THEtheChad/STM32H753-Dashboard/Dash Reference.jpg

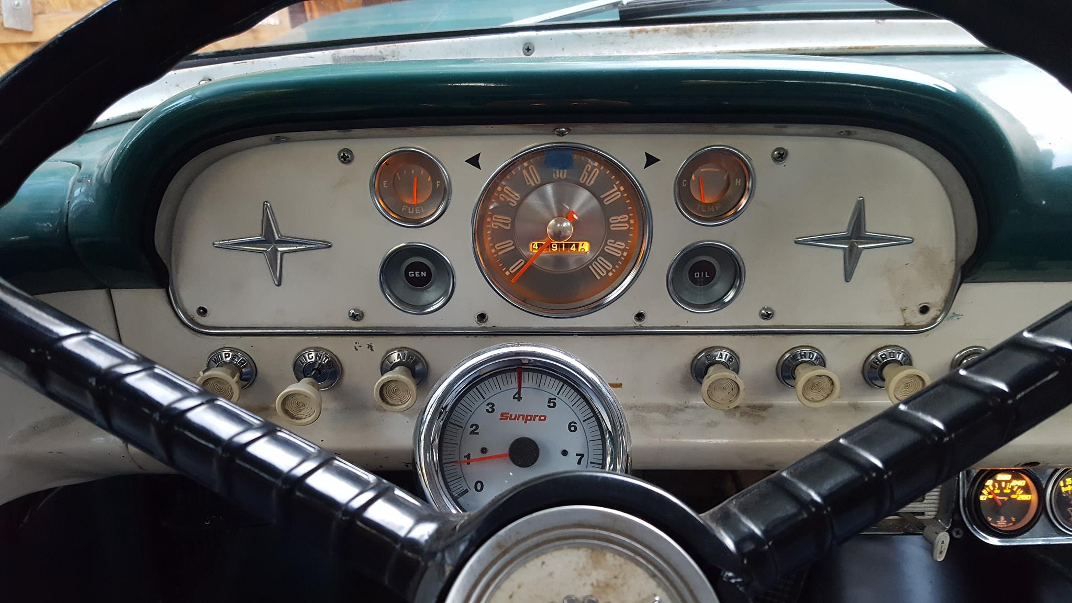
Dash Reference.jpg
