THEtheChad/STM32H753-Dashboard/docs/vss-jumper.png

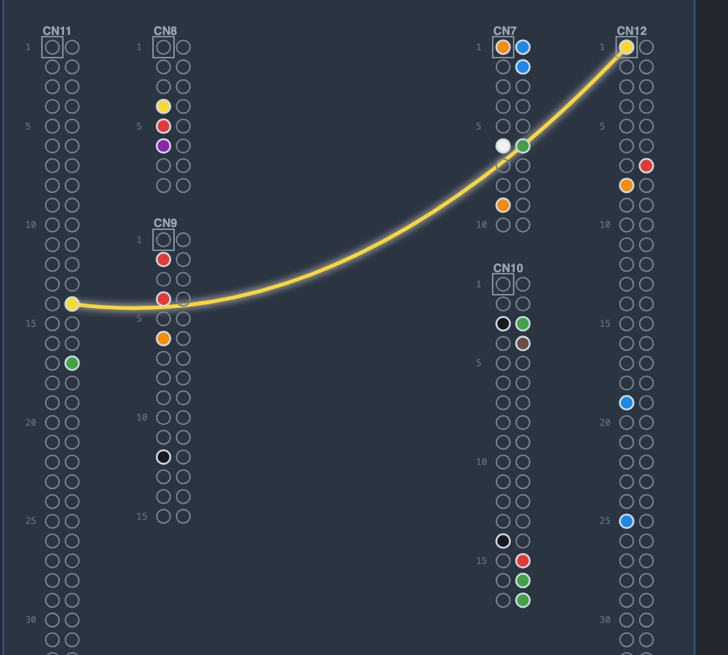
docs/vss-jumper.png
