THEtheChad/STM32H753-Dashboard/Core/Src/main.c

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
/* Includes ------------------------------------------------------------------*/
#include "main.h"

/* USER CODE BEGIN Includes */
#include "st77916.h"
#include "nv3052c.h"
#include "holley_can.h"
#include "sensors.h"
#include "inputs.h"
#include "config.h"
/* USER CODE END Includes */

ADC_HandleTypeDef hadc1;

DMA2D_HandleTypeDef hdma2d;

FDCAN_HandleTypeDef hfdcan1;

I2C_HandleTypeDef hi2c1;

LTDC_HandleTypeDef hltdc;

QSPI_HandleTypeDef hqspi;

SPI_HandleTypeDef hspi1;

TIM_HandleTypeDef htim1;
TIM_HandleTypeDef htim2;
TIM_HandleTypeDef htim6;

UART_HandleTypeDef huart1;
UART_HandleTypeDef huart2;

void SystemClock_Config(void);
static void MPU_Config(void);
static void MX_GPIO_Init(void);
static void MX_ADC1_Init(void);
static void MX_DMA2D_Init(void);
static void MX_FDCAN1_Init(void);
static void MX_I2C1_Init(void);
static void MX_LTDC_Init(void);
static void MX_QUADSPI_Init(void);
static void MX_SPI1_Init(void);
static void MX_TIM1_Init(void);
static void MX_TIM2_Init(void);
static void MX_TIM6_Init(void);
static void MX_USART1_UART_Init(void);
static void MX_USART2_UART_Init(void);
/**
  * @brief  The application entry point.
  * @retval int
  */
int main(void)
{

  /* MPU Configuration--------------------------------------------------------*/
  MPU_Config();

  /* MCU Configuration--------------------------------------------------------*/

  /* Reset of all peripherals, Initializes the Flash interface and the Systick. */
  HAL_Init();

  /* USER CODE BEGIN Init */
  /* Framebuffer RAM (AXI SRAM) as write-through: CPU writes reach RAM
   * immediately and in order, so LTDC scanout never sees stale or
   * half-flushed pixels and no per-frame cache maintenance is needed.
   * With write-back this raced the scanline and tore the moving needle.
   * Region 0 (background) is CubeMX-generated; this stacks region 1. */
  {
    MPU_Region_InitTypeDef r = {0};
    HAL_MPU_Disable();
    r.Enable           = MPU_REGION_ENABLE;
    r.Number           = MPU_REGION_NUMBER1;
    r.BaseAddress      = 0x24000000U;
    r.Size             = MPU_REGION_SIZE_512KB;
    r.TypeExtField     = MPU_TEX_LEVEL0;          /* TEX=0, C=1, B=0 = write-through */
    r.AccessPermission = MPU_REGION_FULL_ACCESS;
    r.DisableExec      = MPU_INSTRUCTION_ACCESS_DISABLE;
    r.IsShareable      = MPU_ACCESS_NOT_SHAREABLE;
    r.IsCacheable      = MPU_ACCESS_CACHEABLE;
    r.IsBufferable     = MPU_ACCESS_NOT_BUFFERABLE;
    HAL_MPU_ConfigRegion(&r);
    HAL_MPU_Enable(MPU_PRIVILEGED_DEFAULT);
  }
  /* CPU caches were never enabled; the Cortex-M7 is crippled without them and
   * cache-maintenance ops (used for LTDC framebuffer coherence) hard-fault if
   * executed while the D-cache is off. MPU_Config() has already run. */
  SCB_EnableICache();
  SCB_EnableDCache();
  /* USER CODE END Init */

  /* Configure the system clock */
  SystemClock_Config();

  /* Initialize all configured peripherals */
  MX_GPIO_Init();
  MX_ADC1_Init();
  MX_DMA2D_Init();
  MX_FDCAN1_Init();
  MX_I2C1_Init();
  MX_LTDC_Init();
  MX_QUADSPI_Init();
  MX_SPI1_Init();
  MX_TIM1_Init();
  MX_TIM2_Init();
  MX_TIM6_Init();
  MX_USART1_UART_Init();
  MX_USART2_UART_Init();
  /* USER CODE BEGIN 2 */
  HAL_GPIO_WritePin(LCD_BACKLIGHT_GPIO_Port, LCD_BACKLIGHT_Pin, GPIO_PIN_SET);
  ST77916_InitAll();
  ST77916_Fill(ST77916_DISPLAY_ALL, 0, 0, ST77916_WIDTH - 1, ST77916_HEIGHT - 1, 0x07E0); /* solid green */
  NV3052C_Init();
  Holley_CAN_Init();
  Config_Init();
  Sensors_Init();
  Inputs_Init();
  /* USER CODE END 2 */

  /* Infinite loop */
  /* USER CODE BEGIN WHILE */
  while (1)
  {
    /* USER CODE END WHILE */

    /* USER CODE BEGIN 3 */
    Holley_CAN_Update();
    Sensors_Update();
    Inputs_Update();
    Config_BtUpdate();
    NV3052C_Update();
  }
  /* USER CODE END 3 */
}

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
 /* MPU Configuration */

void MPU_Config(void)
{
  MPU_Region_InitTypeDef MPU_InitStruct = {0};

  /* Disables the MPU */
  HAL_MPU_Disable();

  /** Initializes and configures the Region and the memory to be protected
  */
  MPU_InitStruct.Enable = MPU_REGION_ENABLE;
  MPU_InitStruct.Number = MPU_REGION_NUMBER0;
  MPU_InitStruct.BaseAddress = 0x0;
  MPU_InitStruct.Size = MPU_REGION_SIZE_4GB;
  MPU_InitStruct.SubRegionDisable = 0x87;
  MPU_InitStruct.TypeExtField = MPU_TEX_LEVEL0;
  MPU_InitStruct.AccessPermission = MPU_REGION_NO_ACCESS;
  MPU_InitStruct.DisableExec = MPU_INSTRUCTION_ACCESS_DISABLE;
  MPU_InitStruct.IsShareable = MPU_ACCESS_SHAREABLE;
  MPU_InitStruct.IsCacheable = MPU_ACCESS_NOT_CACHEABLE;
  MPU_InitStruct.IsBufferable = MPU_ACCESS_NOT_BUFFERABLE;

  HAL_MPU_ConfigRegion(&MPU_InitStruct);
  /* Enables the MPU */
  HAL_MPU_Enable(MPU_PRIVILEGED_DEFAULT);

}

/**
  * @brief  This function is executed in case of error occurrence.
  * @retval None
  */
void Error_Handler(void)
{
  /* USER CODE BEGIN Error_Handler_Debug */
  /* User can add his own implementation to report the HAL error return state */
  __disable_irq();
  while (1)
  {
  }
  /* USER CODE END Error_Handler_Debug */
}
#ifdef USE_FULL_ASSERT
/**
  * @brief  Reports the name of the source file and the source line number
  *         where the assert_param error has occurred.
  * @param  file: pointer to the source file name
  * @param  line: assert_param error line source number
  * @retval None
  */
void assert_failed(uint8_t *file, uint32_t line)
{
  /* USER CODE BEGIN 6 */
  /* User can add his own implementation to report the file name and line number,
     ex: printf("Wrong parameters value: file %s on line %d\r\n", file, line) */
  /* USER CODE END 6 */
}
#endif /* USE_FULL_ASSERT */
