THEtheChad/STM32H753-Dashboard/STM32H753-Dashboard.ioc

Mcu.UserName=STM32H753ZITx
PA0.GPIO_Label=VSS_INPUT
PA0.Signal=S_TIM2_CH1_ETR
PA1.GPIO_Label=OIL_PRESSURE_IN
PA1.Signal=ADC1_INP17
PA11.Signal=LTDC_R4
PA12.Signal=FDCAN1_TX
PA2.GPIO_Label=COOLANT_TEMP_IN
PA2.Signal=ADCx_INP14
PA3.Signal=LTDC_B5
PA4.Signal=LTDC_VSYNC
PA6.Signal=LTDC_G2
PB0.Signal=LTDC_R3
PB1.Signal=LTDC_R6
PB10.Signal=LTDC_G4
PB11.Signal=LTDC_G5
PB12.GPIO_Label=TURN_LEFT_IN
PB12.Signal=GPIO_Input
PB13.GPIO_Label=TURN_RIGHT_IN
PB13.Signal=GPIO_Input
PB14.GPIO_Label=BT_TX
PB14.Signal=USART1_TX
PB15.GPIO_Label=BT_RX
PB15.Signal=USART1_RX
PB2.Signal=QUADSPI_CLK
PB6.GPIO_Label=EEPROM_SCL
PB6.Signal=I2C1_SCL
PB7.GPIO_Label=EEPROM_SDA
PB7.Signal=I2C1_SDA
PB8.Signal=LTDC_B6
PB9.Signal=LTDC_B7
PC0.Signal=LTDC_R5
PC1.GPIO_Label=BATT_VOLTAGE_IN
PC1.Signal=ADCx_INP11
PC5.Signal=ADCx_INP8
PC6.Signal=LTDC_HSYNC
PC7.Signal=LTDC_G6
PD0.Signal=FDCAN1_RX
PD10.Signal=LTDC_B3
PD11.GPIO_Label=ST77916_CS1
PD11.Signal=GPIO_Output
PD12.GPIO_Label=ST77916_CS2
PD12.Signal=GPIO_Output
PD13.GPIO_Label=ST77916_CS3
PD13.Signal=GPIO_Output
PD5.GPIO_Label=DEBUG_TX
PD5.Signal=USART2_TX
PD6.GPIO_Label=DEBUG_RX
PD6.Signal=USART2_RX
PD7.Signal=SPI1_MOSI
PD8.GPIO_Label=LCD_BACKLIGHT
PD8.Signal=GPIO_Output
PD9.GPIO_Label=HIGHBEAM_IN
PD9.Signal=GPIO_Input
PE11.Signal=LTDC_G3
PE12.Signal=LTDC_B4
PE14.Signal=LTDC_CLK
PE15.Signal=LTDC_R7
PE2.Signal=QUADSPI_BK1_IO2
PE9.GPIO_Label=TACH_INPUT
PE9.Signal=S_TIM1_CH1
PF10.Signal=LTDC_DE
PF12.GPIO_Label=DIMMER_IN
PF12.Signal=ADC1_INP6
PF6.Signal=QUADSPI_BK1_IO3
PF8.Signal=QUADSPI_BK1_IO0
PF9.Signal=QUADSPI_BK1_IO1
PG11.Signal=SPI1_SCK
PG2.GPIO_Label=ST77916_CS4
PG2.Signal=GPIO_Output
PG3.GPIO_Label=ST77916_RST
PG3.Signal=GPIO_Output
PG4.GPIO_Label=NV3052C_CS
PG4.Signal=GPIO_Output
PG5.GPIO_Label=NV3052C_RST
PG5.Signal=GPIO_Output
PG6.Signal=QUADSPI_BK1_NCS
PG8.Signal=LTDC_G7
PG9.Signal=SPI1_MISO
