THEtheChad/STM32H753-Dashboard/Display/nv3052c.c

#include "nv3052c.h"
#include "gauge.h"
#include "sources.h"
#include <math.h>

extern LTDC_HandleTypeDef hltdc;

/* L8 (palettized) framebuffer at a fixed address in AXI SRAM (RAM_D1, 512 KB).
 * Linker .bss lives in DTCMRAM (0x20000000) which is CPU-private — LTDC, an AXI
 * master, cannot read it. A pointer to 0x24000000 sidesteps the linker entirely.
 * 720*720*1 byte = 506.25 KB of the 512 KB bank; a full RGB565 buffer (1013 KB)
 * would not fit in any single bank, which is why the layer runs L8 + CLUT. */
/* The static face lives in FLASH (Gauge_FaceImg, generated at build time
 * by tools/genface.c) and the LTDC fetches layer 1 straight from there —
 * the D2 SRAM banks turned out to be unreachable by the LTDC's bus master
 * (continuous TERRIF transfer errors). That frees the whole 512 KB AXI
 * SRAM for the needle sprite ping-pong buffers (AL44, 352x352): the back
 * buffer is drawn off-screen, then layer 2's shadow registers flip to it
 * atomically at vertical blanking — tear-free by construction. The AXI
 * SRAM is write-through (MPU region 1), so no cache maintenance needed. */
static uint8_t * const spr[2] = { (uint8_t *)0x24000000U, (uint8_t *)0x24020000U };
#define SPR_BYTES  (GAUGE_SPR_PITCH * GAUGE_SPR_MAX)
static int spr_back;
static float spr_mph[2] = { -1.0f, -1.0f };   /* shape each buffer holds */

/* needle-draw cost telemetry, readable over SWD (tools/perf notes) */
volatile uint32_t NV3052C_NeedleCycles, NV3052C_NeedleCyclesMax;
volatile uint32_t NV3052C_FrameIntervalMs;

/* -------------------------------------------------------------------------
 * Bit-bang 9-bit SPI
 * PA7=MOSI, PG11=SCK, PG4=CS  (Mode 3: idle HIGH, latch on rising edge)
 * -------------------------------------------------------------------------*/
#define BB_MOSI_PORT  GPIOA
#define BB_MOSI_PIN   GPIO_PIN_7
#define BB_SCK_PORT   GPIOG
#define BB_SCK_PIN    GPIO_PIN_11

/* PE14 = LTDC_CLK. Force it LOW as a GPIO during SPI init so the NV3052C
 * doesn't see a running pixel clock and ignore our SPI commands. */
#define LTDC_CLK_PORT  GPIOE
#define LTDC_CLK_PIN   GPIO_PIN_14

static void bb_spi_init(void)
{
    GPIO_InitTypeDef g = {0};
    g.Mode  = GPIO_MODE_OUTPUT_PP;
    g.Pull  = GPIO_NOPULL;
    g.Speed = GPIO_SPEED_FREQ_LOW;

    /* Hold LTDC pixel clock pin LOW — prevents NV3052C from ignoring SPI */
    g.Pin = LTDC_CLK_PIN;
    HAL_GPIO_Init(LTDC_CLK_PORT, &g);
    HAL_GPIO_WritePin(LTDC_CLK_PORT, LTDC_CLK_PIN, GPIO_PIN_RESET);

    g.Pin   = BB_MOSI_PIN;
    HAL_GPIO_Init(BB_MOSI_PORT, &g);
    g.Pin   = BB_SCK_PIN;
    HAL_GPIO_Init(BB_SCK_PORT, &g);

    HAL_GPIO_WritePin(BB_SCK_PORT,  BB_SCK_PIN,  GPIO_PIN_SET);   /* SCK idle HIGH */
    HAL_GPIO_WritePin(BB_MOSI_PORT, BB_MOSI_PIN, GPIO_PIN_RESET);
    HAL_GPIO_WritePin(NV3052C_CS_GPIO_Port, NV3052C_CS_Pin, GPIO_PIN_SET);
}

static void ltdc_clk_restore(void)
{
    GPIO_InitTypeDef g = {0};
    g.Mode      = GPIO_MODE_AF_PP;
    g.Pull      = GPIO_NOPULL;
    g.Speed     = GPIO_SPEED_FREQ_VERY_HIGH;   /* 48 MHz PCLK needs fast slew */
    g.Alternate = GPIO_AF14_LTDC;
    g.Pin       = LTDC_CLK_PIN;
    HAL_GPIO_Init(LTDC_CLK_PORT, &g);
}

/* Edge pacing: at 400 MHz the raw GPIO loop would clock SPI near the
 * NV3052C's limits; ~150 ns per phase keeps SCK a comfortable ~2 MHz.
 * Init is ~200 writes — still done in single-digit milliseconds. */
static inline void bb_delay(void) { for (volatile int d = 0; d < 20; d++) {} }

/* Clock out one 9-bit word (D/C bit + 8 data bits). CS must already be LOW. */
static void spi_word_9(uint16_t word)
{
    for (int i = 8; i >= 0; i--) {
        HAL_GPIO_WritePin(BB_SCK_PORT,  BB_SCK_PIN,  GPIO_PIN_RESET);
        HAL_GPIO_WritePin(BB_MOSI_PORT, BB_MOSI_PIN, ((word >> i) & 1) ? GPIO_PIN_SET : GPIO_PIN_RESET);
        bb_delay();
        HAL_GPIO_WritePin(BB_SCK_PORT,  BB_SCK_PIN,  GPIO_PIN_SET);
        bb_delay();
    }
}

/* One command and all its parameters inside a single CS frame.
 * The previous driver raised CS after every 9-bit word; multi-parameter
 * commands — critically the 0xFF page select, which per datasheet 5.x takes
 * its three parameters (0x30, 0x52, page) as ONE command frame — may never
 * have taken effect, leaving pages 1-3 of the init unapplied. */
static void nv_write(uint8_t cmd, const uint8_t *params, size_t n)
{
    HAL_GPIO_WritePin(NV3052C_CS_GPIO_Port, NV3052C_CS_Pin, GPIO_PIN_RESET);
    spi_word_9(cmd);
    for (size_t i = 0; i < n; i++)
        spi_word_9(0x100u | params[i]);
    HAL_GPIO_WritePin(NV3052C_CS_GPIO_Port, NV3052C_CS_Pin, GPIO_PIN_SET);
}

static inline void nv_reg(uint8_t r, uint8_t v) { nv_write(r, &v, 1); }

static void nv_page(uint8_t page)
{
    const uint8_t p[3] = {0x30, 0x52, page};
    nv_write(0xFF, p, 3);
}

/* -------------------------------------------------------------------------
 * Init register table (page-switched layout)
 * -------------------------------------------------------------------------*/
typedef struct { uint8_t reg; uint8_t val; } nv_reg_t;

static const nv_reg_t nv_init[] = {
    /* Page 1: Power, VCOM, analog */
    {0xFF,0x30},{0xFF,0x52},{0xFF,0x01},
    {0xE3,0x00},{0x0A,0x11},{0x23,0xA0},{0x24,0x32},{0x25,0x12},  /* 0x23=0xA0 = manufacturer's value (DE-only). Earlier 0x80 experiment predates the CS-framing fix, when page-1 writes likely never applied. */
    {0x26,0x2E},{0x27,0x2E},{0x29,0x02},{0x2A,0xCF},{0x32,0x34},
    {0x38,0x9C},{0x39,0xA7},{0x3A,0x27},{0x3B,0x94},
    {0x42,0x6D},{0x43,0x83},{0x81,0x00},
    {0x91,0x67},{0x92,0x67},
    {0xA0,0x52},{0xA1,0x50},{0xA4,0x9C},{0xA7,0x02},{0xA8,0x02},
    {0xA9,0x02},{0xAA,0xA8},{0xAB,0x28},{0xAE,0xD2},{0xAF,0x02},
    {0xB0,0xD2},{0xB2,0x26},{0xB3,0x26},

    /* Page 2: Gamma */
    {0xFF,0x30},{0xFF,0x52},{0xFF,0x02},
    {0xB1,0x0A},{0xD1,0x0E},{0xB4,0x2F},{0xD4,0x2D},
    {0xB2,0x0C},{0xD2,0x0C},{0xB3,0x30},{0xD3,0x2A},
    {0xB6,0x1E},{0xD6,0x16},{0xB7,0x3B},{0xD7,0x35},
    {0xC1,0x08},{0xE1,0x08},{0xB8,0x0D},{0xD8,0x0D},
    {0xB9,0x05},{0xD9,0x05},{0xBD,0x15},{0xDD,0x15},
    {0xBC,0x13},{0xDC,0x13},{0xBB,0x12},{0xDB,0x10},
    {0xBA,0x11},{0xDA,0x11},{0xBE,0x17},{0xDE,0x17},
    {0xBF,0x0F},{0xDF,0x0F},{0xC0,0x16},{0xE0,0x16},
    {0xB5,0x2E},{0xD5,0x3F},{0xB0,0x03},{0xD0,0x02},

    /* Page 3: GIP timing & pin mapping */
    {0xFF,0x30},{0xFF,0x52},{0xFF,0x03},
    {0x08,0x09},{0x09,0x0A},{0x0A,0x0B},{0x0B,0x0C},
    {0x28,0x22},{0x2A,0xE9},{0x2B,0xE9},
    {0x34,0x51},{0x35,0x01},{0x36,0x26},{0x37,0x13},
    {0x40,0x07},{0x41,0x08},{0x42,0x09},{0x43,0x0A},
    {0x44,0x22},{0x45,0xDB},{0x46,0xDC},{0x47,0x22},{0x48,0xDD},{0x49,0xDE},
    {0x50,0x0B},{0x51,0x0C},{0x52,0x0D},{0x53,0x0E},
    {0x54,0x22},{0x55,0xDF},{0x56,0xE0},{0x57,0x22},{0x58,0xE1},{0x59,0xE2},
    {0x80,0x1E},{0x81,0x1E},{0x82,0x1F},{0x83,0x1F},
    {0x84,0x05},{0x85,0x0A},{0x86,0x0A},{0x87,0x0C},{0x88,0x0C},
    {0x89,0x0E},{0x8A,0x0E},{0x8B,0x10},{0x8C,0x10},
    {0x8D,0x00},{0x8E,0x00},{0x8F,0x1F},{0x90,0x1F},
    {0x91,0x1E},{0x92,0x1E},{0x93,0x02},{0x94,0x04},
    {0x96,0x1E},{0x97,0x1E},{0x98,0x1F},{0x99,0x1F},
    {0x9A,0x05},{0x9B,0x09},{0x9C,0x09},{0x9D,0x0B},{0x9E,0x0B},
    {0x9F,0x0D},{0xA0,0x0D},{0xA1,0x0F},{0xA2,0x0F},
    {0xA3,0x00},{0xA4,0x00},{0xA5,0x1F},{0xA6,0x1F},
    {0xA7,0x1E},{0xA8,0x1E},{0xA9,0x01},{0xAA,0x03},

    /* Page 0: Display control */
    {0xFF,0x30},{0xFF,0x52},{0xFF,0x00},

    /* MADCTL — bit assignments per NV3052CGRB datasheet 5.2.21:
     *   D3 = bgr  (0 = RGB, 1 = BGR color filter order)
     *   D1 = ss   (0 = source scan L→R, 1 = source scan R→L)
     *   D0 = gs   (0 = gate scan T→B,  1 = gate scan B→T)
     *
     * Historical half-split evidence (pre CS-framing fix): the garbled half
     * followed the ss bit (0x0A → left garbled, 0x00 → right garbled), i.e.
     * whichever bank latches the LATE pixels of each line. Video analysis
     * showed the garbled half never latches ANY data (stripes frozen across
     * BCCR color changes) — consistent with the panel running on power-on
     * defaults because the page 1-3 init never applied (see nv_write). */
    {0x36,0x02},  /* MADCTL — golden value is 0x0A, but its bgr bit (D3) assumes
                   * a BGR-ordered host bus; our LTDC wiring is straight RGB
                   * (verified in pinout.md), and 0x0A rendered red as blue.
                   * 0x02 keeps ss=1 (scan direction) with bgr=0. */
};

/* -------------------------------------------------------------------------
 * Public API
 * -------------------------------------------------------------------------*/

void NV3052C_Init(void)
{
    /* Stop LTDC — NV3052C ignores SPI while PCLK is running */
    __HAL_LTDC_DISABLE(&hltdc);
    HAL_Delay(20);

    bb_spi_init();

    /* Hardware reset */
    HAL_GPIO_WritePin(NV3052C_RST_GPIO_Port, NV3052C_RST_Pin, GPIO_PIN_SET);
    HAL_Delay(10);
    HAL_GPIO_WritePin(NV3052C_RST_GPIO_Port, NV3052C_RST_Pin, GPIO_PIN_RESET);
    HAL_Delay(15);
    HAL_GPIO_WritePin(NV3052C_RST_GPIO_Port, NV3052C_RST_Pin, GPIO_PIN_SET);
    HAL_Delay(150);

    /* Send init sequence. The table keeps the manufacturer's layout where a
     * page switch appears as three consecutive 0xFF entries (0x30, 0x52, page);
     * those are collapsed into one 3-parameter command frame here. */
    for (size_t i = 0; i < sizeof(nv_init) / sizeof(nv_reg_t); i++) {
        if (nv_init[i].reg == 0xFF) {
            nv_page(nv_init[i + 2].val);
            i += 2;
        } else {
            nv_reg(nv_init[i].reg, nv_init[i].val);
        }
    }

    nv_reg(0x11, 0x00);   /* Sleep Out */
    HAL_Delay(200);
    nv_reg(0x29, 0x00);   /* Display On */
    HAL_Delay(100);

    /* Face is pre-rendered in flash; only the sprite buffers need setup */
    for (uint32_t i = 0; i < SPR_BYTES; i++) { spr[0][i] = 0; spr[1][i] = 0; }

    /* DWT cycle counter for draw-cost telemetry */
    CoreDebug->DEMCR |= CoreDebug_DEMCR_TRCENA_Msk;
    DWT->CYCCNT = 0;
    DWT->CTRL |= DWT_CTRL_CYCCNTENA_Msk;

    ltdc_clk_restore();
    __HAL_LTDC_ENABLE(&hltdc);
    hltdc.Instance->BCCR = 0x00000000U;

    /* Layer 0: L8 + CLUT, full screen, opaque. Configured here rather than in
     * the CubeMX-generated MX_LTDC_Init so an .ioc regeneration can't stomp it
     * (MX_LTDC_Init's placeholder layer config is simply overwritten). */
    {
        LTDC_LayerCfgTypeDef cfg = {0};
        cfg.WindowX0 = 0; cfg.WindowX1 = NV3052C_WIDTH;
        cfg.WindowY0 = 0; cfg.WindowY1 = NV3052C_HEIGHT;
        cfg.PixelFormat = LTDC_PIXEL_FORMAT_L8;
        cfg.Alpha = 255;
        cfg.Alpha0 = 0;
        cfg.BlendingFactor1 = LTDC_BLENDING_FACTOR1_CA;
        cfg.BlendingFactor2 = LTDC_BLENDING_FACTOR2_CA;
        cfg.FBStartAdress = (uint32_t)Gauge_FaceImg;   /* static face, in flash */
        cfg.ImageWidth  = NV3052C_WIDTH;
        cfg.ImageHeight = NV3052C_HEIGHT;
        HAL_LTDC_ConfigCLUT(&hltdc, (uint32_t *)Gauge_CLUT, 256, 0);
        HAL_LTDC_EnableCLUT(&hltdc, 0);
        HAL_LTDC_ConfigLayer(&hltdc, &cfg, 0);
    }

    /* Layer 1 (index 1): the needle sprite, AL44 with per-pixel alpha so
     * everything outside the needle is transparent over the face. */
    {
        int x, y, w, h;
        Gauge_DrawNeedleSprite(spr[0], 0.0f, spr_mph[0], &x, &y, &w, &h);
        spr_mph[0] = 0.0f;
        LTDC_LayerCfgTypeDef cfg = {0};
        cfg.WindowX0 = (uint32_t)x; cfg.WindowX1 = (uint32_t)(x + w);
        cfg.WindowY0 = (uint32_t)y; cfg.WindowY1 = (uint32_t)(y + h);
        cfg.PixelFormat = LTDC_PIXEL_FORMAT_AL44;
        cfg.Alpha = 255;
        cfg.Alpha0 = 0;
        cfg.BlendingFactor1 = LTDC_BLENDING_FACTOR1_PAxCA;
        cfg.BlendingFactor2 = LTDC_BLENDING_FACTOR2_PAxCA;
        cfg.FBStartAdress = (uint32_t)spr[0];
        cfg.ImageWidth  = GAUGE_SPR_PITCH;
        cfg.ImageHeight = (uint32_t)h;
        HAL_LTDC_ConfigCLUT(&hltdc, (uint32_t *)Gauge_CLUT, 256, 1);
        HAL_LTDC_EnableCLUT(&hltdc, 1);
        HAL_LTDC_ConfigLayer(&hltdc, &cfg, 1);
        spr_back = 1;
    }
}

/* Animate the needle locked to the panel's vertical blanking (~74.9 Hz):
 * as soon as the previous flip has latched, draw the next frame and
 * queue it — every panel refresh carries a fresh needle position, the
 * smoothest cadence this glass can display (no pulldown judder). An
 * ignition sweep (0-100-0), then a simulated cruise until real speed
 * data arrives; damping is time-based so the feel is frame-rate
 * independent. The needle is drawn into the OFF-SCREEN sprite buffer,
 * then layer 2's shadow registers flip atomically at vblank. */
void NV3052C_Update(void)
{
    static uint32_t lastFrame = 0;
    static float    shown     = 0.0f;

    /* previous flip not yet latched by the hardware? try again next pass */
    if (hltdc.Instance->SRCR & (LTDC_SRCR_VBR | LTDC_SRCR_IMR)) return;

    uint32_t now = HAL_GetTick();
    float dt = (float)(now - lastFrame);
    NV3052C_FrameIntervalMs = now - lastFrame;
    lastFrame = now;

    float target;
    if (now < 3000U) {                      /* ignition sweep, up then back */
        float t = (float)now / 1500.0f;     /* 0..2 */
        target = (t < 1.0f ? t : 2.0f - t) * 100.0f;
    } else {                                /* live: VSS pulses or Holley CAN
                                               via the source-selection policy */
        target = Source_SpeedMph();
    }
    if (target < 0.0f)   target = 0.0f;
    if (target > 100.0f) target = 100.0f;

    /* damped needle, ~123 ms time constant regardless of frame rate
     * (matches the old 0.15-per-20ms feel) */
    shown += (target - shown) * (1.0f - expf(-dt / 123.0f));

    /* draw into the back buffer (invisible), then queue the atomic flip */
    int x, y, w, h;
    uint32_t t0 = DWT->CYCCNT;
    Gauge_DrawNeedleSprite(spr[spr_back], shown, spr_mph[spr_back], &x, &y, &w, &h);
    NV3052C_NeedleCycles = DWT->CYCCNT - t0;
    if (NV3052C_NeedleCycles > NV3052C_NeedleCyclesMax)
        NV3052C_NeedleCyclesMax = NV3052C_NeedleCycles;
    spr_mph[spr_back] = shown;
    __DSB();                                /* sprite writes drained to RAM */

    uint32_t ahbp = (hltdc.Instance->BPCR >> 16) & 0xFFFU;
    uint32_t avbp =  hltdc.Instance->BPCR & 0x7FFU;
    LTDC_Layer2->WHPCR  = (((uint32_t)(x + w) + ahbp) << 16) | ((uint32_t)x + ahbp + 1U);
    LTDC_Layer2->WVPCR  = (((uint32_t)(y + h) + avbp) << 16) | ((uint32_t)y + avbp + 1U);
    LTDC_Layer2->CFBAR  = (uint32_t)spr[spr_back];
    LTDC_Layer2->CFBLR  = ((uint32_t)GAUGE_SPR_PITCH << 16) | ((uint32_t)w + 7U);
    LTDC_Layer2->CFBLNR = (uint32_t)h;
    hltdc.Instance->SRCR = LTDC_SRCR_VBR;   /* latch all of it at next vblank */

    spr_back ^= 1;
}
