THEtheChad/STM32H753-Dashboard/Display/gauge.h

#ifndef GAUGE_H
#define GAUGE_H

#include <stdint.h>

/* 256-entry CLUT for the L8 framebuffer (0x00RRGGBB, LTDC CLUTWR layout) */
extern const uint32_t Gauge_CLUT[256];

/* Pre-rendered 720x720 L8 face, generated into flash by tools/genface.c */
extern const uint8_t Gauge_FaceImg[720 * 720];

/* One-shot render: face + needle (used by the host-side preview). */
void Gauge_RenderSpeedo(uint8_t *fb, int w, int h, float mph);

/* Split API for animation: render the static face once, then move the
 * needle as often as desired. Gauge_SetNeedle restores the pixels under
 * the previous needle from an undo log, draws the new one, and reports
 * the dirty byte range within the framebuffer (for targeted cache
 * cleaning); pass NULL if unwanted. */
void Gauge_RenderFace(uint8_t *fb, int w, int h);
void Gauge_SetNeedle(float mph, uint32_t *dirty_first, uint32_t *dirty_last);

/* Needle-as-sprite for hardware compositing on a second LTDC layer.
 * Draws the needle in AL44 (high nibble alpha, low nibble CLUT index)
 * into a GAUGE_SPR_PITCH-stride buffer, clearing exactly the bounding
 * box it uses. Returns the sprite's screen position and size. */
#define GAUGE_SPR_PITCH 352
#define GAUGE_SPR_MAX   352
void Gauge_DrawNeedleSprite(uint8_t *buf, float mph, float prev_mph,
                            int *x, int *y, int *w, int *h);

#endif /* GAUGE_H */
