THEtheChad/STM32H753-Dashboard/(commit log)

2026-07-24 fix(display): repair NV3052C SPI CS framing and LTDC DE polarity
    Two stacked bugs caused the long-standing 50/50 split:
    1. The bit-bang 9-bit SPI raised CS after every word, but the 0xFF
    page-select takes its three parameters (0x30, 0x52, page) in one CS
    frame. The page never switched, so the entire page 1-3 vendor init
    (source timing, gamma, VCOM) silently never applied. On POR defaults
    the panel loads only ~360 of 720 columns per line: the half receiving
    each line's late pixels was never latched (frozen "barcode" tracking
    MADCTL ss) and colors were washed out. nv_write() now holds CS low
    across a command and all its parameters.
    2. With the init applied, the panel obe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
    [main.c, nv3052c.c]
2026-07-24 feat(tools): add interactive bench wiring recorder
    Self-contained SVG page (no dependencies, works via file://) for
    transcribing the physical jumper harness: NUCLEO-H753ZI Zio+morpho
    headers (CN7-CN12, transcribed from ST's official MB1364 diagrams and
    cross-checked against the .ioc pin set), FPC-40P breakout, and the
    DC-DC module. Click-click to record a wire in a sticky DuPont color;
    one wire per pin enforced (two per DC-DC pad); zoom/pan; localStorage
    autosave; JSON export/import. Deliberately records positions only (no
    signal-role labels) so the transcription stays unbiased; verification
    happens by diffing the export against the expected netlist.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
2026-07-25 feat(tools): add GND stakes below CN11/CN12 to wiring recorder
    Nucleo-144 boards expose two ground pins under each morpho header;
    they were missing from the pin catalog and are plausible landing spots
    for the harness ground jumpers.
2026-07-25 feat(tools): replace drawn wires with pin rings and row-count guides
    Bench feedback: permanently drawn wires didn't help and the recording
    error found in review was a row-counting slip.
    - Wires are no longer drawn by default. A bound pin wears a thick ring
    in its wire's color (fill lightened so black rings read on the dark
    theme). Hovering a bound pin reveals just that wire, halos the
    partner pin, and the tooltip names the far end and color. Clicking a
    bound pin selects its connection for recolor/delete.
    - Row-count guides (1, 5, 10, ...) beside every Nucleo connector, and
    all tooltips now state the physical position: "CN10 pin 7 (row 4,
    left) - PF4". FPC keeps silk-matching odd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
2026-07-25 fix(tools): bound-pin rings rendered grey due to SVG style cascade
    The ring color was set via SVG presentation attributes, which lose to
    the stylesheet's .pin stroke/fill rules in the SVG cascade — so bound
    pins showed only a thicker grey ring. Set inline styles instead, which
    outrank both.
2026-07-25 feat(tools): fill bound pins with wire color
    Black rings were hard to tell from unbound grey pins. Empty pins are
    now hollow grey circles; bound pins fill solid with their wire color
    and get a slightly brighter outline so dark fills still read.
2026-07-25 docs(wiring): add verified bench harness pinout
    Generated from the wiring-map.html export after physical verification:
    35/35 connections match the netlist expected from the .ioc, driver
    code, and panel spec. Records the B2 fix (was on floating PF4 since
    original assembly, moved to GND) and the known backlight-return
    improvement for later.
2026-07-25 feat(tools): support multi-wire DC-DC pads with pie fill and pick menu
    Solder pads genuinely stack wires (the LEDK rework needs two on OUT-),
    so DC-DC pads now take up to 4. A pad with several wires renders as a
    pie of their colors; clicking it opens a mini-menu anchored at the pad
    listing each wire (color chip + far end) plus "+ start new wire" when
    capacity remains. Header pins keep the one-wire cap and direct
    click-to-select. Data model and export schema unchanged.
2026-07-25 docs(wiring): record LEDK star-ground rework and add canonical wiring JSON
    Backlight return reworked on the bench: both LEDK wires (FPC 2/3) now
    land on the DC-DC OUT- pad and the redundant OUT-/logic-ground jumper
    is removed, so LED current loops locally at the converter and the
    module bonds to logic ground once via IN-. Re-verified 34/34.
    The recorder export now lives at docs/wiring-map.json (re-importable
    canonical record); pinout.md is regenerated from it and notes the
    regeneration workflow.
2026-07-25 chore(ide): update ST extension bundle state and C/C++ config
    Local state written by the STM32Cube VS Code extension while setting up
    the build environment on a new machine.
2026-07-25 feat(display): render retro speedometer via L8 palettized framebuffer
    First real pixels. A full 720x720 RGB565 framebuffer (1013 KB) fits in
    no single H753 RAM bank, so layer 0 runs L8 + CLUT: 720x720x1 byte =
    506.25 KB, just inside the 512 KB AXI SRAM at 0x24000000.
    - Display/gauge.c: pure-C renderer (no HAL dependency, host-testable) —
    chrome bezel, charcoal face, cream ticks/numerals on a 240-degree
    0-120 MPH sweep, 5x7 bitmap font, tapered needle (static 55 MPH until
    live data arrives).
    - nv3052c.c: diagnostic BCCR cycle replaced with gauge render + dcache
    clean + CLUT/layer config. Layer is configured in the driver, not in
    CubeMX-generated MX_LTDC_Init, so .ioc regeneration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
    [gauge.c, gauge.h, nv3052c.c, nv3052c.h]
2026-07-25 chore(ide): run to completion on F5 instead of halting at main
    Removes runEntry (which plants a temporary breakpoint at main on
    launch) and overrides quickReset — whose default is ["monitor reset",
    "tbreak main", "continue"] — so both the launch flow and the quick
    reset button reset and run free. Halting at main left the backlight
    GPIO unset, showing a dead-black screen that repeatedly read as a
    hardware failure.
2026-07-25 fix(core): enable CPU caches; guard framebuffer cache-clean
    The gauge firmware hard-faulted before enabling the LTDC, leaving a
    black screen. SWD post-mortem: CFSR=0x0400 (imprecise BusFault),
    stacked PC inside the SCB_CleanDCache_by_Addr loop, SCB->CCR showing
    both caches disabled — cache maintenance by address with the D-cache
    off is unpredictable on the Cortex-M7 and bus-faults on the H753.
    The landmine predates the gauge: NV3052C_SetColor carried the same
    call, but no diagnostic build ever executed it.
    - main.c (USER CODE Init): enable I/D caches at boot — required for
    the clean to be legal, and a large performance win besides. The MPU
    default-map attributes are already correct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
    [main.c, nv3052c.c]
2026-07-25 feat(display): animate the speedometer needle at 50 FPS
    Split the renderer into a one-time face render and a per-frame
    Gauge_SetNeedle: pixels under the needle are recorded in an undo log
    (no RAM exists for a second framebuffer) and restored before each
    redraw, with the needle geometry kept strictly outside the hub so
    nothing else ever repaints. Only the dirty byte span is cache-cleaned
    per frame.
    Until real speed data is wired in, NV3052C_Update plays an ignition
    sweep (0-120-0) and then a layered-sine cruise, low-pass filtered for
    damped instrument-like motion.
    Correctness verified host-side: 200 random needle moves then memcmp
    against a pristine one-shot render at the same position —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
    [gauge.c, gauge.h, nv3052c.c]
2026-07-25 fix(display): eliminate needle tearing; correct red/blue channel swap
    - Tearing: the needle update ran whenever the frame timer fired,
    racing the panel's scanout — rows caught between erase and redraw
    showed as dark slashes across the moving needle. The update is now
    gated into vertical blanking via LTDC CPSR (~1.2 ms window vs a few
    hundred µs of work); if the scanline is mid-frame the update punts
    to the next main-loop pass. Not a throughput problem — pure
    synchronization.
    - Color: MADCTL golden value 0x0A carries bgr=1, which assumes a
    BGR-ordered host bus; our LTDC wiring is straight RGB (pinout.md),
    so red rendered as blue. Now 0x02 (bgr=0, ss unchanged).
    Co-Author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
    [nv3052c.c]
2026-07-25 fix(display): make framebuffer write-through to kill residual tearing
    The vsync gate synchronized CPU writes, but with a write-back D-cache
    the panel only sees pixels at the explicit cache clean — and the span
    clean (up to ~240 KB with a near-vertical needle) could outlast the
    blanking window, especially when the gate fired late in blanking.
    MPU region 1 now maps the AXI SRAM framebuffer as write-through
    (TEX=0/C=1/B=0): writes reach RAM immediately and in order, the
    per-frame span clean is deleted, and the needle update drops to a few
    hundred µs — comfortably inside blanking from any entry point.
    Verified on target via MPU RBAR/RASR readback; fault registers clean.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
    [main.c, nv3052c.c]
2026-07-25 feat(display): hardware-composited needle on LTDC layer 2 (tear-proof)
    Single-buffer approaches kept trading artifact flavors: write-back
    caching tore at flush time; write-through made every write instantly
    visible, so scanout caught the needle mid-erase whenever the update
    overran blanking (disappearing segments, phantom transparency).
    The needle now renders as an AL44 sprite into one of two ping-pong
    buffers in the otherwise-unused D2 SRAM banks (write-through via MPU
    region 2) while the other is displayed. Layer 2's window position,
    size, address, and pitch shadow registers then flip to the fresh
    buffer and latch atomically at vertical blanking (SRCR_VBR). A
    partially drawn needle is unr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
    [gauge.c, gauge.h, main.c, nv3052c.c]
2026-07-25 feat(tools): SWD framebuffer screenshot tool (tools/fbshot.py)
    Dumps LTDC layer 1 (face) and the displayed layer 2 needle sprite plus
    live window registers over SWD (brief halt, then resume), composites
    through the CLUT parsed from gauge.c, and writes a pixel-perfect PNG
    of what the LTDC is scanning out. Ends the photograph-the-screen loop
    for content-level display debugging.
2026-07-25 fix(display): face in flash, sprites in AXI SRAM — LTDC cannot fetch D2
    The invisible needle was an LTDC transfer error: the layer 2 sprite
    buffers lived in D2 SRAM, which the LTDC bus master cannot reach
    (continuous TERRIF, confirmed by clear-and-recheck). Config registers
    all looked correct — only the fetch itself failed.
    - The static face is now pre-rendered at build time (tools/genface.c)
    into flash (Display/face_img.c); LTDC scans layer 1 straight from
    flash. This frees the entire 512 KB AXI SRAM for the sprite
    ping-pong buffers, which the LTDC demonstrably fetches fine.
    - CLUT entries are mirrored at index i and i*17: AL44 expands its
    4-bit index to {L,L} before lookup, so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
    [gauge.c, gauge.h, main.c, nv3052c.c]
2026-07-25 feat(display): redesign gauge after the 1960 F-100 reference photo
    Face rebuilt to match Dash Reference.jpg (amber night-lit): spun
    aluminum center dome with anisotropic lobes, radial brush streaks and
    concentric sheen; warm bronze band with fine 2-MPH ticks at the rim,
    square dots, and 0-100 numerals every 10, rotated tangentially with
    tops outward (verified against the reference crop — 80/90/100 read
    sideways on the real gauge too); odometer drum window frozen at the
    photo's 47,914; unlit turn arrows flanking the top as on the cluster
    panel; chrome hub ball; thin orange lance needle with a dark edge on
    the sprite layer. Sweep is now authentic 0-100 (animation clamps
    updated).
    fbshot: pa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
    [gauge.c, nv3052c.c]
2026-07-25 perf(display): angle-flat needle rasterization
    The needle was sluggish ~45 degrees off center: the old rasterizer
    walked the sprite's bounding box doing per-pixel distance math (with a
    float divide), and the box is ~7x larger at diagonal angles than
    axis-aligned — geometry-dependent frame cost on a 64 MHz core.
    - Rasterize by walking ALONG the needle spine painting perpendicular
    spans: cost proportional to needle area, identical at every angle,
    no divides in the inner loop.
    - Erase by re-walking the previous frame's shape in transparent
    (caller passes the mph each buffer holds) — eliminates the full
    bounding-box clear; two floats of state instead of a pixel log.
    - DWT cycle-coun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
2026-07-25 feat(core): run the CPU at 400 MHz (was 64 MHz HSI)
    SYSCLK moves from raw HSI to PLL1: VOS1, HSI/4 ref, VCO 800 MHz,
    /2 = 400 MHz CPU, HCLK 200, all APB 100 (timer kernels 200),
    FLASH_LATENCY_2 + WRHIGHFREQ=0b10 per RM0433.
    Blast-radius audit and containment:
    - LTDC (PLL3) and ADC (PLL2) untouched — independent PLLs.
    - pll1_q pinned at 50 MHz via Q=16 so FDCAN (Holley, 1 Mbps) and SPI1
    bit timings are unchanged.
    - QSPI prescaler 4 -> 15: ST77916 SCK stays ~12.5 MHz at the faster
    kernel clock.
    - I2C1 kernel mux -> HSI so the generated TIMINGR stays valid
    (~50 kHz SCL, in spec for the EEPROM) independent of bus clocks.
    - inputs.c derives VSS timer clock and tach prescaler from the liv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
2026-07-25 docs(readme): refresh current status past the diagnostic era
    Status still described the BCCR color-cycle diagnostic; the center
    display has since gained the full F-100 gauge, sprite needle, 400 MHz
    core, and tooling. Also corrects the MADCTL note (0x02 in use, not
    golden 0x0A, for the straight-RGB bus).
2026-07-25 perf(display): vblank-locked needle updates (~75 FPS)
    Replaces the 20 ms frame timer with the panel itself as the frame
    clock: a new frame is drawn the moment the previous layer-2 flip has
    latched, so every LTDC refresh (74.9 Hz) carries a fresh needle
    position — no pulldown judder, the smoothest cadence the glass can
    display. (60 FPS was the request, but 60 into a 74.9 Hz panel would
    double every fourth frame; locking to refresh is both smoother and
    more.)
    Needle damping switched to a time-based coefficient (~123 ms time
    constant, matching the previous feel) so response is frame-rate
    independent. Frame-interval telemetry added alongside the cycle
    counter; on-target readings show steady 1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
    [nv3052c.c]
2026-07-25 feat(inputs): drive the needle from real VSS speed
    After the ignition sweep, the needle target comes from
    Source_SpeedMph() — the existing source-selection policy (VSS pulse
    capture with Holley CAN fallback, per calibration) — instead of the
    simulated cruise. Display damping unchanged.
    Bench test signal (VSS_TEST_SIGNAL, default on until the truck):
    TIM3_CH4 PWM on PC9 sweeps a 0-100-0 MPH profile over 24 s using the
    configured pulses-per-mile. Jumper PC9 (morpho CN12 pin 1) to the VSS
    input PA0 (Zio CN10 pin 29) and the gauge displays speed genuinely
    measured by the capture -> SMA -> sources pipeline.
    Also corrects the swapped VSS/TACH pin labels (.ioc, main.h, MSP):
    PA0/TIM2 is VSS a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
    [STM32H753-Dashboard.ioc, inputs.c, main.h, nv3052c.c]
2026-07-25 docs(vss): record bring-up status and exact pickup point
    VSS-to-needle work paused mid-debug: firmware proven end-to-end (a
    contact-bounce burst drove the needle to 100 through the real capture
    pipeline), test PWM verified live on PC9, both pin muxes confirmed —
    but the bench jumper conducts nothing (full-chip GPIO scan found no
    follower and no load on either end; suspected broken crimp).
    docs/vss-bringup-status.md captures what is proven, the pending
    wire-continuity test with exact SWD commands (PA0 pull-up must be
    re-armed after any reset), the intended final jumper (CN12-1 -> CN11-28,
    illustrated in docs/vss-jumper.png with the harness as landmarks), and
    the post-fix checklist. README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
